chcbaram/convex/firmware/convex-boot/docs/web_update_plan.md

# 웹페이지 → 앱 경유 펌웨어 업데이트 / SLOT 저장 검토

질문: "앱에서 웹페이지를 통해 펌웨어 업데이트와 SLOT 데이터 저장을 지원하고 싶다.
부트로더가 아니라 앱에만 추가하면 될 것 같은데 맞나?"

**결론: 맞다. 부트로더 수정 없이 앱(`convex-qmk`) + 웹페이지만으로 구현 가능하다.**
그리고 이 방식은 이미 출하된 보드에도 그대로 적용된다 — 부트로더의 MSC/UF2 문제를
전부 우회하기 때문에, 출하품 대응의 실질적인 해법이다.

구현은 부트로더 수정과 같은 `fix/uf2-msc-robustness` 브랜치에서 이어서 진행한다.

---

## 1. 왜 부트로더 수정이 필요 없는가

부트로더가 이미 "QSPI 업데이트 영역을 읽어 내부 플래시에 적용"하는 경로를 갖고 있고,
그 트리거가 RTC 백업 레지스터에 있기 때문이다.

`convex-boot/src/ap/ap.c` `bootUp()`:

```c
if (boot_param & (1<<MODE_BIT_UPDATE))
{
  boot_param &= ~(1<<MODE_BIT_UPDATE);
  resetSetBootMode(boot_param);
  is_run_fw    = true;
  is_update_fw = true;
}
...
if (is_update_fw)
{
  err_code = bootUpdateFirm();     // CRC 검증 -> 내부 플래시 erase/write -> 재검증
}
```

즉 앱이 할 일은 **QSPI 업데이트 영역 채우기 + 태그 쓰기 + `MODE_BIT_UPDATE` 세팅 후 리셋**이 전부다.
MSC·UF2·FAT·파일 복사는 전혀 개입하지 않는다.

앱 쪽 부품도 이미 다 있다:

| 필요한 것 | 이미 있는 것 | 위치 |
|---|---|---|
| QSPI 업데이트 영역 기록 + 태그 생성 | `loaderDownToFlash()` (UART/YMODEM 판) | `convex-qmk/src/hw/driver/loader.c` |
| 업데이트 모드로 리셋 | `resetSetBootMode(1<<MODE_BIT_UPDATE)` + `resetToReset()` | `convex-qmk/src/hw/driver/reset.c:163` |
| 슬롯 영역 읽기/재생 | `gif_app.c` + LVGL FS 드라이버 | `convex-qmk/.../app/gif/gif_app.c` |
| 플래시 추상화 | `flashErase/flashWrite/flashRead` (QSPI 자동 라우팅) | `convex-qmk/src/hw/driver/flash.c` |

바꿔야 할 것은 **전송 계층뿐**이다. YMODEM/UART → 웹 브라우저.

---

## 2. 동작 흐름

### 2-1. 펌웨어 업데이트

```
웹페이지                    앱(convex-qmk)                     부트로더
   |                            |                                |
   |-- BEGIN(FIRM, size) ------>| QSPI 업데이트 영역 erase        |
   |<-- ACK ---------------------|                                |
   |-- DATA(offset, payload) -->| flashWrite(0x90000400+offset)   |
   |        ... 반복 ...         |                                |
   |-- END(crc) --------------->| flash 재독 -> CRC 검증          |
   |                            | firm_tag_t 를 0x90000000 에 기록 |
   |<-- RESULT(ok/err) ----------|                                |
   |-- COMMIT ----------------->| resetSetBootMode(MODE_BIT_UPDATE)|
   |                            | resetToReset() ---------------->| bootUpdateFirm()
   |                            |                                 | CRC 검증
   |                            |                                 | 내부 플래시 복사
   |                            |                                 | bootJumpFirm()
```

**안전성**: 앱은 QSPI(외부 플래시)에만 쓴다. 실행 중인 펌웨어는 내부 플래시에 그대로 있으므로
전송이 중간에 끊겨도 벽돌이 되지 않는다. 부트로더도 `bootUpdateFirm()` 에서 CRC 를 먼저 검증하고,
실패하면 기존 펌웨어로 그냥 부팅한다.

### 2-2. SLOT 데이터 저장

부트로더가 아예 개입하지 않으므로 더 간단하다.

```
웹 -- BEGIN(SLOT n, size) --> 앱: 슬롯 전체(2MB) erase
    -- DATA(offset, ...) ---> 앱: flashWrite(slot_base + 0x400 + offset)
    -- END(crc) ------------> 앱: flash 재독 CRC 검증 -> 결과 회신
```

리셋도 필요 없다. `gif_app` 의 `slot_run` 을 `SLOT_MAX_CH` 로 되돌리면 다음 진입 때 다시 읽는다.

헤더 규약은 지금 `index.html` 이 만드는 것과 동일하게 유지한다
(0..15 매직 문자열, 16..19 파일 크기 LE, 32부터 원본). 기존 UF2 경로와 호환된다.

---

## 3. 전송 계층 선택 (Windows / macOS / Linux 모두 지원해야 함)

이 보드는 이미 **raw HID(VIA)** 와 **CDC** 인터페이스를 모두 노출한다
(`convex-qmk/src/hw/driver/usb/usb_cmp/usbd_cmp.c`, `hw_def.h` 의 `_USE_HW_CDC`).
새 USB 인터페이스를 추가하지 않아도 된다.

| 방식 | OS 지원 | 브라우저 | 드라이버/권한 | 속도 |
|---|---|---|---|---|
| **WebHID** (raw HID, usage page 0xFF60) | Win / macOS / Linux 모두 | Chrome·Edge (Safari·Firefox ✗) | Win·macOS 무설정. **Linux 는 udev 규칙 필요** | report 64B 기준 full-speed 1ms → 실효 수십 KB/s |
| **WebSerial** (CDC) | Win / macOS / Linux 모두 | Chrome·Edge (Safari·Firefox ✗) | Win10+ 자동(usbser). macOS 무설정. **Linux 는 dialout 그룹 또는 udev** | bulk 64B×여러 패킷 → 수백 KB/s |
| WebUSB (vendor 인터페이스 신설) | Win 은 WinUSB 바인딩 필요(WCID 디스크립터) | Chrome·Edge | Linux udev 필요 | 가장 빠름 |

### 권장

**WebHID 를 기본, WebSerial 을 대용량용으로** 두는 조합을 권한다.

- WebHID 는 VIA 가 정확히 같은 인터페이스로 세 OS에서 동작하는 것이 검증돼 있고,
  Linux udev 규칙도 키보드 커뮤니티에서 이미 표준화된 형태가 있다.
- 다만 raw HID 는 report 크기가 작아 1.7MB 펌웨어 전송에 수십 초가 걸린다.
  펌웨어와 대용량 GIF 는 CDC(WebSerial)가 현실적이다.
- WebUSB 는 Windows 에서 WinUSB 바인딩을 위해 WCID(MS OS 2.0) 디스크립터를 추가해야 해서
  "세 OS 무설정" 목표에 오히려 불리하다. 권하지 않는다.

### 반드시 챙길 것

1. **HTTPS 필수** — WebHID/WebSerial 은 secure context 에서만 동작한다.
   지금처럼 GitHub Pages 로 서비스하면 충족된다. `file://` 로 열면 동작하지 않는다.
2. **Safari / Firefox 미지원** — 웹페이지에서 `navigator.hid`/`navigator.serial` 존재 여부를
   먼저 검사하고, 없으면 "Chrome 또는 Edge 를 사용하세요 + 기존 UF2 다운로드" 대체 경로를 안내한다.
   기존 UF2 생성기를 지우지 말고 fallback 으로 남겨둘 것.
3. **Linux 권한 안내** — udev 규칙(`/etc/udev/rules.d/`) 예시를 페이지에 함께 제공한다.
   이게 없으면 Linux 에서 장치가 목록에 뜨지 않는다. 세 OS 지원에서 가장 흔한 실패 지점이다.
4. **사용자 제스처 필요** — `requestDevice()` 는 클릭 등 사용자 조작 안에서만 호출 가능하다.

---

## 4. 프로토콜 설계 권고

부트로더 UF2 경로에서 문제가 됐던 것들을 처음부터 배제하는 형태로 만든다.

| 규칙 | 이유 |
|---|---|
| 모든 DATA 패킷에 **절대 오프셋**을 넣는다 | 순서/중복에 무관해진다. UF2 경로의 B-1~B-3 이 전부 이 문제였다 |
| erase 는 **BEGIN 에서 대상 영역 전체를 한 번에** | 블록 단위 on-demand erase 는 순서가 뒤바뀌면 기록한 데이터를 지운다 |
| END 에서 **기기가 flash 를 다시 읽어 CRC 검증** 후 결과 회신 | MSC 로는 불가능했던 "성공/실패를 사용자에게 알리기"가 된다 |
| 모든 명령에 응답(ACK/NAK + 상태 코드) | 실패를 성공으로 보고하던 A-4 문제가 구조적으로 사라진다 |
| 진행률을 LCD 에 표시 | 기존 `lcd_req_info_t` / `LCD_INFO_MODE_PROGRESS` 재사용 |

명령 예시:

```
BEGIN  : target(FIRM|SLOT), slot_no, total_size          -> ACK / ERR_SIZE, ERR_BUSY
DATA   : offset(u32), len(u16), payload                  -> ACK / ERR_WRITE
END    : crc16(u16)                                      -> ACK / ERR_CRC
COMMIT : (FIRM 일 때만) 업데이트 모드로 리셋              -> (응답 후 리셋)
STATUS : 진행 상태 조회                                   -> state, percent, err_code
```

---

## 5. 앱 구현 시 주의할 점

1. **QSPI XIP 모드** — `qspiRead/Write/Erase` 에 `assert(qspiGetXipMode() == false)` 가 있다.
   GIF 재생 경로와 기록 경로가 QSPI 를 동시에 건드리지 않도록 락 또는 상태 배타 처리가 필요하다.
2. **erase 블로킹** — 64KB erase 가 150ms 이상 걸린다. 슬롯 2MB 전체면 32회 = 약 5초.
   `_USE_HW_RTOS` 가 켜져 있으므로 별도 스레드에서 진행하고, 키 스캔/USB/LCD 는 계속 돌게 한다.
   한 번에 다 지우지 말고 청크로 나눠 진행률을 갱신하는 편이 사용자 경험상 낫다.
3. **런타임 동적 할당 금지** — 고정 크기 수신 버퍼를 쓴다.
4. **기존 UF2 경로와 공존** — 부트로더 MSC 경로는 그대로 남는다.
   웹 방식이 안정화되면 사용자 안내에서 UF2 드래그 방식을 보조 수단으로 내리는 것을 권한다.

---

## 6. 부트로더 자체를 앱에서 갱신할 수 있는가

**가능하다.** 흔히 쓰는 방식이기도 하다 (Adafruit 은 `update-bootloader-*.uf2` 라는
"부트로더를 갱신하는 앱 펌웨어"를 배포한다). 다만 조건이 있다.

### 6-1. 이 보드의 조건 (스키매틱 5페이지 `R_MCU` 확인)

| 항목 | 확인 결과 |
|---|---|
| MCU | STM32H743VIT6 (2MB, dual bank, **섹터 128KB**, 뱅크당 8섹터) |
| 부트로더 영역 | `0x08000000`~`0x0803FFFF` = **bank1 섹터 0~1** 에 정확히 정렬됨 |
| 펌웨어 영역 | `0x08040000`~ = bank1 섹터 2~7 + bank2 전체 |
| **BOOT0 버튼** | **있음.** `SW2`(TS-1187A) 가 BOOT0 를 `R_+3V3` 에 연결, `R5` 10k 풀다운 |
| **RESET 버튼** | **있음.** `SW1`(TS-1187) 이 NRST 에 연결 |
| SWD / UART 헤더 | **있음.** `H1`(PH-01291) 에 SWDIO / SWCLK / USART1_TX / USART1_RX |
| USB | Type-C, D+/D− 가 PA11/PA12 (ST ROM 부트로더의 DFU 핀과 동일) |

**즉 최악의 경우 복구 경로가 존재한다.** BOOT0 를 누른 채 RESET → STM32 ROM 부트로더
(system memory) 진입 → USB DFU 로 STM32CubeProgrammer / dfu-util 재기록.
SWD 나 UART 부트로더로도 가능하다.
이것이 "부트로더 갱신을 시도해도 되는가"를 가르는 핵심 근거다.

> **기구 확인 필요**: 조립된 상태에서 사용자가 BOOT0/RESET 버튼에 접근할 수 있는가?
> 접근 가능하면 실패해도 사용자 자력 복구가 되고, 불가능하면 분해/RMA 가 된다.
> 이 한 가지가 리스크 수용 여부를 결정한다.

### 6-2. 반드시 지켜야 할 구현 조건

1. **erase/program 루틴을 RAM 에서 실행해야 한다.** ← 가장 중요
   갱신 코드는 bank1 섹터 2 이후에 있고 지우려는 대상은 bank1 섹터 0~1 이다.
   STM32H7 은 erase/program 중인 뱅크로의 읽기가 stall 되므로, **같은 뱅크에서 실행하면 안 된다.**
   루틴(그리고 그 루틴이 호출하는 HAL 코드·상수)을 ITCM/DTCM 으로 복사해 실행하고
   인터럽트를 끄거나 벡터 테이블을 RAM 으로 옮긴다.
   - 현재 `flashWrite()` 는 대상 주소를 `memcpy` 로 되읽는 코드가 있어 그대로는 못 쓴다.
     부트로더 갱신 전용으로 32바이트 정렬·전체 이미지 기록만 하는 별도 루틴을 둔다.
   - bank2(`0x08100000`+)에 링크해 cross-bank read-while-write 로 푸는 방법도 있으나,
     호출되는 모든 코드/상수 배치를 보장해야 해서 취약하다. RAM 방식이 확실하다.
2. **H7 은 32바이트(256bit) 플래시 워드 단위로 기록하고, erase 없이 같은 워드를 두 번 쓸 수 없다.**
   이미지 전체를 32바이트 정렬로 한 번에 기록한다.
3. **새 부트로더 이미지를 QSPI 에 먼저 저장하고 CRC 검증에 통과한 뒤에만** 내부 플래시를 건드린다.
   전송 실패로 인한 브릭을 원천 차단한다.
4. **취약 구간을 짧게.** 256KB = 128KB 섹터 2개 erase + 프로그램 → 대략 1~3초.
   그동안 "케이블을 뽑지 마세요"를 LCD 에 표시한다. USB 버스 파워라 사용자가 뽑으면 끝이다.
5. 갱신 후 **재검증(CRC)** 하고, 실패하면 즉시 재시도하도록 유도한다.

### 6-3. 검토했으나 이 보드에는 쓸 수 없는 안전장치

`BOOT_ADD0` 옵션 바이트로 부트 주소를 임시로 펌웨어 쪽으로 돌려두면, 부트로더가 지워진 상태에서
전원이 끊겨도 다음 부팅에 펌웨어가 떠서 재시도할 수 있다. 이론상 가장 강한 보호책이다.

**그러나 지금 구조에는 적용할 수 없다.** `BOOT_ADD` 는 64KB 단위로만 지정되는데,
펌웨어의 실제 벡터 테이블은 태그(`FLASH_SIZE_TAG` = 0x400) 때문에 `0x08040400` 에 있다.
`0x08040000` 을 지정하면 태그를 벡터 테이블로 오인한다.

→ 쓰려면 태그를 벡터 뒤로 옮기거나 `0x08040000` 에 64KB 정렬 복구 스텁을 두는 **구조 변경**이
필요하고, 이는 출하품에 소급 적용할 수 없다. 차기 리비전 설계 시 고려할 항목이다.

### 6-4. 권고

in-place 방식은 아래 7절의 A/B 방식보다 모든 면에서 열등하다. **7절을 채택한다.**

---

## 7. A/B 방식 — 실제 플래시 사용 현황과 두 가지 안

### 7-1. 현재 내부 플래시 사용 현황 (실측)

STM32H743VI = 2MB, dual bank, 뱅크당 1MB / 128KB 섹터 8개.

| 영역 | 주소 | 크기 | 뱅크 |
|---|---|---|---|
| 부트로더 | `0x08000000`~`0x0803FFFF` | 256KB (실제 text 133KB) | bank1 섹터 0~1 |
| 펌웨어 | `0x08040000`~`0x080E55A8` | **661KB** (태그 포함, 실측) | bank1 섹터 2~7 |
| **미사용** | `0x080E55A8`~`0x080FFFFF` | 약 107KB | bank1 |
| **미사용** | `0x08100000`~`0x081FFFFF` | **1MB 전체** | **bank2** |

실측 방법: `convex-qmk` 빌드 → `convex-qmk.bin` = 676,264 B, `+ FLASH_SIZE_TAG(0x400)` = 677,288 B.
끝 주소 `0x080E55A8` 은 뱅크 경계 `0x08100000` 아래다.

EEPROM 은 외부 I2C(`BL24C256`, 스키매틱 U119)를 쓰므로 내부 플래시를 점유하지 않는다.
즉 **bank2 1MB 는 완전히 비어 있다.**

> 참고: `hw_def.h` 의 `FLASH_SIZE_FIRM` 은 1.75MB, `STM32H743XX_FLASH_BOOT.ld` 의 FLASH LENGTH 는
> `1024K - 3K` 로 선언되어 있어 **정의상으로는** 펌웨어가 bank2 로 넘어갈 수 있다.
> 아래 두 안 모두 펌웨어를 bank1 안에 묶어야 하므로 이 값들을 조여야 한다.

### 7-2. 안 A — `BOOT_ADD0` 로 부트로더만 A/B

새 부트로더를 `0x08100000`(bank2 섹터 0~1, 64KB 정렬 ✔)에 기록하고 검증한 뒤
`BOOT_ADD0` 를 `0x0810` 으로 바꾸고 OB launch → 리셋.

- 기존 부트로더는 `0x08000000` 에 그대로 남아 있으므로 **부트로더가 없는 순간이 존재하지 않는다.**
- 실패해도 `BOOT_ADD0` 를 안 바꾸면 그만이다. 롤백도 값만 되돌리면 된다.
- 펌웨어 영역을 줄일 필요가 없다 (bank2 가 비어 있으므로).
- **단점**: 슬롯 B 는 `0x08100000` 에서 실행되므로 **그 주소로 따로 링크한 빌드**가 필요하다.
  A 슬롯용/B 슬롯용 두 벌을 유지해야 하고, 매번 "지금 어느 슬롯인지" 보고 반대편에 써야 한다.

### 7-3. 안 B — `SWAP_BANK` 로 부트로더+펌웨어 통째로 A/B  ← **권장**

STM32H7 은 `SWAP_BANK` 옵션 비트로 **bank1 과 bank2 의 주소 맵을 통째로 맞바꾼다.**
정확히 이 용도로 있는 기능이다.

현재 이미지 총합 = 부트로더 256KB + 펌웨어 661KB = **917KB → 1MB 뱅크 하나에 들어간다.**

```
        [현재]                              [SWAP_BANK 플립 후]
0x08000000  물리 bank1 (구 부트로더+펌웨어)   0x08000000  물리 bank2 (신 부트로더+펌웨어)
0x08100000  물리 bank2 (신 이미지 기록 대상)  0x08100000  물리 bank1 (구 이미지 = 롤백용)
```

절차:
1. 앱이 **부트로더+펌웨어를 합친 새 이미지**를 `0x08100000` 에 기록 (현재 실행 중인 bank1 과 다른 뱅크)
2. flash 재독 CRC 검증
3. `SWAP_BANK` 옵션 비트 플립 → OB launch → 리셋
4. 새 이미지가 `0x08000000` 에 나타나 부팅

**결정적 장점: 재링크가 필요 없다.** 기록할 때는 `0x08100000` 에 쓰지만 플립 후에는 그 뱅크가
`0x08000000` 이 되므로, 이미지는 **지금과 똑같이 `0x08000000` 기준으로 링크된 것**을 그대로 쓴다.
안 A 의 가장 큰 부담(슬롯별 링크 주소 관리)이 사라진다.

부가 장점:
- **부트로더와 펌웨어를 한 번에, 원자적으로** 교체한다.
- 롤백 = 옵션 비트를 되돌리면 끝. 구 이미지가 반대 뱅크에 온전히 남아 있다.
- 실행 중인 코드(bank1)와 기록 대상(bank2)이 다른 뱅크라 **cross-bank read-while-write** 가 되므로,
  in-place 방식에서 필수였던 RAM 상주 루틴이 없어도 된다.

제약:
- **이미지 총합이 1MB 를 넘으면 안 된다.** 현재 917KB, 여유 107KB.
  펌웨어 상한을 768KB(= 1MB − 부트로더 256KB)로 잡고 `_BOOT.ld` 의 FLASH LENGTH 를
  `1024K - 3K` → `768K - 3K` 로 조여 링커가 강제하게 한다.
  LVGL·GIF 디코더가 들어 있어 증가 여지가 있으므로 **크기 감시가 필요하다.**
- 구현 전 **RM0433 에서 확인할 것**:
  `SWAP_BANK` 설정 시 FLASH 제어 레지스터의 뱅크 번호도 함께 스왑되는지 (erase 대상 지정에 직결).
  그리고 STM32H743 errata sheet 의 `SWAP_BANK` 관련 항목.
- 옵션 바이트 기록은 OB launch 로 리셋을 동반한다.

### 7-4. 세 방식 비교

| | in-place (6절) | 안 A `BOOT_ADD0` | 안 B `SWAP_BANK` |
|---|---|---|---|
| 부트로더 없는 취약 구간 | **1~3초 존재** | 없음 | 없음 |
| 커밋 동작 | 없음(순차 기록) | 옵션바이트 1회 | 옵션바이트 1회 |
| 슬롯별 재링크 | 불필요 | **필요** | **불필요** |
| RAM 상주 루틴 | **필수** | 권장 | 불필요 |
| 부트로더+펌웨어 동시 갱신 | 불가 | 불가 | **가능** |
| 롤백 | 불가 | 가능 | 가능 |
| 필요 공간 | 0 | bank2 256KB | bank2 1MB |
| 주 제약 | 브릭 위험 | 슬롯 링크 관리 | 이미지 ≤1MB (현 917KB) |

### 7-5. 권고

1. **안 B(`SWAP_BANK`) 를 채택한다.** 현재 이미지가 917KB 로 한 뱅크에 들어가고,
   재링크가 필요 없다는 점이 결정적이다.
2. 다만 **순서는 4~5절의 앱 경유 웹 업데이트가 먼저다.** 그것만으로 부트로더의 MSC/UF2 문제가
   출하품에서도 우회되므로, 부트로더를 갱신할 이유 자체가 크게 줄어든다.
   부트로더 A/B 는 그 다음 단계로 둔다.
3. 착수 전 확인:
   - RM0433 의 `SWAP_BANK` 레지스터 semantics + H743 errata
   - **BOOT0/RESET 버튼의 조립 후 접근성** (최후 복구 수단이 유지되는지)
   - `BOOT_ADD1` 은 기본값 `0x1FF0`(system memory) 그대로 둘 것.
     여기를 다른 용도로 돌리면 **BOOT0 → ROM DFU 복구 경로를 잃는다.**
4. 새 이미지가 부팅 후 일정 시간 안에 "확인" 플래그를 남기지 않으면 다음 부팅에서 자동으로
   되돌리는 confirm/rollback 절차를 새 부트로더에 넣으면 더 안전하다.

---

## 8. 전송 데이터 압축 검토 (실측)

### 8-1. 압축률 실측

`convex-qmk.bin` (676,264 B) 기준:

| 방식 | 결과 | 비율 |
|---|---|---|
| 원본 | 676,264 B | 100% |
| deflate-raw 전체 스트림 | 376,317 B | **55.6%** |
| 블록 deflate 4KB 단위 | 402,353 B | 59.5% |
| 블록 deflate 8KB 단위 | 394,007 B | 58.3% |
| 블록 deflate 16KB 단위 | 389,764 B | 57.6% |
| lzma/xz | 327,264 B | 48.4% |

**"일정 크기 단위로 나눠 압축해도 되는가" → 된다.**
4KB 블록 단위로 잘라도 전체 스트림 대비 손해가 **3.9%p** 뿐이다.
블록마다 독립적으로 압축/해제되므로 오프셋 기반 순서·중복 무관 설계도 그대로 유지된다.

### 8-2. 그러나 SLOT(GIF) 은 압축 이득이 없다

**GIF 는 이미 LZW 로 압축된 포맷이다.** 이미 압축된 데이터를 다시 압축하면 이득이 없다는 것을
확인했다 (재압축 결과 100.0%, 즉 제자리).

즉 압축은 **펌웨어에만** 의미가 있고, 정작 자주 하는 작업인 **GIF 슬롯 저장에는 무의미하다.**

### 8-3. 압축보다 리포트 크기를 키우는 쪽이 효과가 크다

VIA raw HID 는 32B 리포트 / `bInterval=1`(full-speed 1ms) 이므로 **32 KB/s 가 물리적 상한**이다.
full-speed interrupt 엔드포인트는 최대 64B 까지 가능하므로, VIA 와 별개의 전용 HID 인터페이스를
64B 리포트로 추가하면 상한이 두 배가 된다. 이건 **GIF 에도 그대로 효과가 있다.**

| 구성 | 펌웨어 676KB | GIF 2MB |
|---|---|---|
| 32B 리포트(VIA 재사용), 무압축 — payload 26B | 26 s | 81 s |
| 32B + 블록 deflate | 16 s | 81 s (이득 없음) |
| **64B 전용 리포트, 무압축 — payload 58B** | **12 s** | **36 s** |
| 64B + 블록 deflate | 7 s | 36 s |

### 8-4. 권고

1. **1단계: 압축 없이 VIA 32B 리포트로 먼저 구현한다.** 동작하는 것을 먼저 확보한다.
   펌웨어 26초, GIF 500KB 20초 — 수용 가능한 수준이다.
2. **압축을 넣는다면 펌웨어에만, 4KB 블록 deflate 로.** GIF/SLOT 에는 넣지 않는다.
   - 호스트측은 Chrome 내장 `CompressionStream('deflate-raw')` 로 의존성 없이 가능하다.
   - 장치측은 tinfl(miniz) 계열 해제기 약 5~10KB 가 필요하다.
     7절 SWAP_BANK A/B 의 여유 107KB 를 잠식하므로 크기 감시가 필요하다.
   - 앱이 해제해서 **원본을 QSPI 에 기록**하므로 태그 CRC 는 원본 기준 그대로다.
     → **부트로더는 전혀 손대지 않아도 된다.**
3. **속도가 더 필요하면 압축보다 64B 전용 HID 인터페이스를 먼저 검토한다.**
   효과가 2.2배로 더 크고, 압축과 달리 GIF 에도 적용된다.
   다만 컴포지트 디스크립터(`usbd_cmp.c`)를 건드려야 하므로 VIA/키보드 열거에 영향이 없는지
   확인이 필요하다.

---

## 9. 웹페이지에서 USB 드라이브에 직접 복사 (File System Access API)

부트로더 MSC 모드로 들어갔을 때, 사용자가 `.uf2` 를 내려받아 손으로 끌어다 놓는 대신
**웹페이지에서 드라이브를 선택하면 바로 써주는 것**이 가능하다.

`window.showDirectoryPicker({ mode: 'readwrite' })` 로 드라이브를 고르게 하고,
`getFileHandle(name, {create:true})` → `createWritable()` → `write()` 로 기록한다.

- 브라우저 지원은 **Chrome·Edge** 로 WebHID 와 동일하다. 즉 제약이 늘지 않는다.
- Windows / macOS / Linux 모두에서 이동식 드라이브 선택이 가능하다.
- **보안상 사용자가 매번 드라이브를 직접 선택해야 한다.** 브라우저가 임의 경로에 조용히 쓰는 것은
  구조적으로 불가능하므로 이 단계는 없앨 수 없다. 다만 핸들을 IndexedDB 에 저장해두고
  `queryPermission()`/`requestPermission()` 으로 재사용하면 다음부터는 클릭 한 번이다.
- **잘못된 드라이브 방지**: 쓰기 전에 `README.TXT` 를 읽어 `BARAM BOOT` 인지, 보드 이름/버전이
  맞는지 확인하고 사용자에게 보여준다. 아니면 거부한다.
- **주의**: 마지막 블록을 받으면 기기가 리셋되어 드라이브가 사라지므로 `close()` 가 예외를 던진다.
  이건 정상 동작이므로 성공으로 처리해야 한다.
  (`createWritable()` 이 임시 파일을 거쳐도 부트로더는 파일명을 보지 않고 섹터 내용의 UF2 매직만
  보므로 문제되지 않는다.)
- **한계**: 이 경로는 결국 OS 파일시스템을 통과하므로 `uf2_msc_review.md` 의 MSC/UF2 문제를
  그대로 안고 간다. **편의 개선이지 견고성 개선이 아니다.**

### 제공 경로 우선순위

| 순위 | 조건 | 방식 |
|---|---|---|
| 1 | Chrome·Edge + 앱 실행 중 | **WebHID 직접 전송** (가장 안전·간편) |
| 2 | Chrome·Edge + 부트로더 MSC 모드 | 드라이브 선택 후 자동 복사 |
| 3 | 그 외 브라우저 | `.uf2` 다운로드 후 수동 복사 (기존 방식 유지) |

---

## 10. 슬롯 목록 UI (검토)

요구: 슬롯 목록에서 현재 상태를 보고, 파일 하나를 지정한 뒤
라디오 버튼으로 넣을 슬롯 하나를 골라 업데이트하거나 UF2 로 내려받는다.

### 10-1. 결론

**가능하고, 지금 넣는 것이 좋다.** 장치에 명령 하나(`CMD_SLOT_INFO`)만 추가하면 된다.

처음에는 "슬롯마다 파일을 지정해 한꺼번에 업데이트"를 검토했으나,
**파일 하나 + 라디오로 슬롯 하나 선택**이 더 낫다는 결론이다.

핵심 가치는 "어느 슬롯에 무엇이 들어 있는지 보면서 고르는 것"인데
그것은 라디오 목록만으로 충분히 달성된다. 슬롯별 파일 지정은 거기에
배치 처리 복잡도만 더한다.

| | 슬롯별 파일 지정 | **파일 1개 + 라디오** |
|---|---|---|
| 웹 코드 | 약 150줄 | 약 70줄 |
| UF2 다운로드 | 파일 여러 개 → ZIP 필요 | **파일 1개, 지금 방식 그대로** |
| 합친 UF2 제약 | 부딪힘 (아래 10-4) | **해당 없음** |
| 전송 시간 | 4슬롯 최대 약 80초, 중단 버튼 필요 | 약 20초, 단순 |
| 실패 처리 | 슬롯별 부분 실패 상태 관리 | 한 번에 하나라 단순 |
| 실제 사용 패턴 | 드묾 (초기 설정 1회) | 흔함 (GIF 교체) |

### 10-2. 슬롯 상태 읽기 — 명령 추가 필요

지금 프로토콜에서 장치 값을 읽는 수단은 `INFO` 뿐이고 VIA 에도 QSPI 를
읽는 명령이 없다. 따라서 `CMD_SLOT_INFO` 가 필요하다.

읽을 정보는 이미 슬롯에 다 있다 (`gif_app.c` 가 쓰는 배치와 동일):

| 오프셋 | 내용 |
|---|---|
| `+0` | 매직 문자열 16B (`GIF_IMAGE` / `GIF_MOVIE`) |
| `+16` | 파일 크기 u32 |
| `+32` | 원본 GIF 시작 → `+32+6` 에 논리 화면 크기 (w, h) |

슬롯당 **사용 여부 · 크기 · 종류 · 해상도**를 전부 회신할 수 있다.
32바이트 리포트 하나에 슬롯 하나씩 담아 4회 왕복이면 끝난다.
슬롯 개수는 `INFO` 가 이미 알려주므로 목록을 하드코딩하지 않아도 된다.

QSPI 읽기는 이미 뮤텍스로 보호되어 GIF 재생과 충돌하지 않는다.

**타이밍**: 프로토콜 v1 은 아직 배포되지 않았다. 지금 넣으면 v1 에 흡수되지만
나중에 넣으면 "구형 펌웨어에서는 슬롯 상태가 안 보임" 분기를 영구히 안게 된다.

### 10-3. 화면 구성

```
파일: [ my.gif ]  412 KB · 284 x 76

  ( ) SLOT 1   GIF_IMAGE   284 x 76   412 KB
  (o) SLOT 2   GIF_MOVIE   284 x 76   980 KB     <- 덮어씀
  ( ) SLOT 3   비어 있음
  ( ) SLOT 4   비어 있음                      [ 새로고침 ]

  [ 기기에 바로 전송 ]  [ 드라이브에 바로 쓰기 ]  [ UF2 다운로드 ]
```

- 선택한 슬롯에 내용이 있으면 "덮어씀"을 표시해 실수를 막는다.
- 전송 성공 후 해당 행만 다시 읽어 갱신한다.
- 파일을 고르면 **미리보기**를 보여준다. `URL.createObjectURL(file)` 을 `<img>` 에
  넣으면 애니메이션 GIF 도 그대로 재생된다. 미리보기 틀을 LCD 와 같은
  284 x 76, 배경 검정, `overflow:hidden`, 이미지 가운데 정렬로 만들면
  기기에서 보이는 모습과 거의 같다
  (`gif_app.c` 도 검정 배경에 `lv_obj_center()` 로 가운데 정렬한다).
  다만 브라우저와 LVGL 의 GIF 디코더가 달라 **재생 가능 여부까지 보장하지는 않는다.**
- **연결 전이거나 구형 펌웨어면** 상태 없이 `SLOT 1~4` 행만 표시한다.
  UF2 다운로드/드라이브 쓰기 경로는 그대로 동작해야 하므로 목록 자체는 항상 보인다.

### 10-4. 참고 — 합친 UF2 가 안 되는 이유

이 설계에서는 해당 없지만 기록해 둔다.
부트로더는 첫 familyID 의 블록이 다 차면 `is_done_req` 를 세우고
`UF2_COMPLETE_WAIT_MS(1000) + UF2_JUMP_WAIT_MS(300)` 뒤 펌웨어로 점프한다.
뒤에 붙인 다른 슬롯 블록은 그 사이에 잘린다.
출하품의 구형 부트로더는 애초에 한 세션에 두 파일을 못 받는다 (B-6).
→ 슬롯을 하나의 UF2 로 합치면 안 된다.

### 10-5. 비용과 되돌리기

| 항목 | 규모 |
|---|---|
| 장치 `CMD_SLOT_INFO` | 약 50줄, 크기 영향 무시 수준 |
| 웹 슬롯 목록 UI | 약 70줄 |
| 위험 | 낮음. 기존 단일 슬롯 경로를 확장하는 형태 |

되돌리기 쉽도록 `try/slot-list` 브랜치에서 **단일 커밋**으로 진행한다.
마음에 들지 않으면 브랜치를 지우고, 좋으면 합친다.

선택 항목: 행마다 "비우기" 버튼을 두려면 `CMD_SLOT_ERASE` 가 추가로 필요하다.
지금은 넣지 않는다.

---

## 11. 그 외 남는 것

- 부트로더 모드로 진입해 UF2 를 드래그하는 기존 경로의 버그는 출하품에 그대로 남는다.
  → `uf2_msc_review.md` 의 C 절 참고. 웹 방식을 기본 경로로 안내해 회피한다.
