chcbaram/convex/hardware/SCH_SCH-CONVEX_2025-11-16.pdf

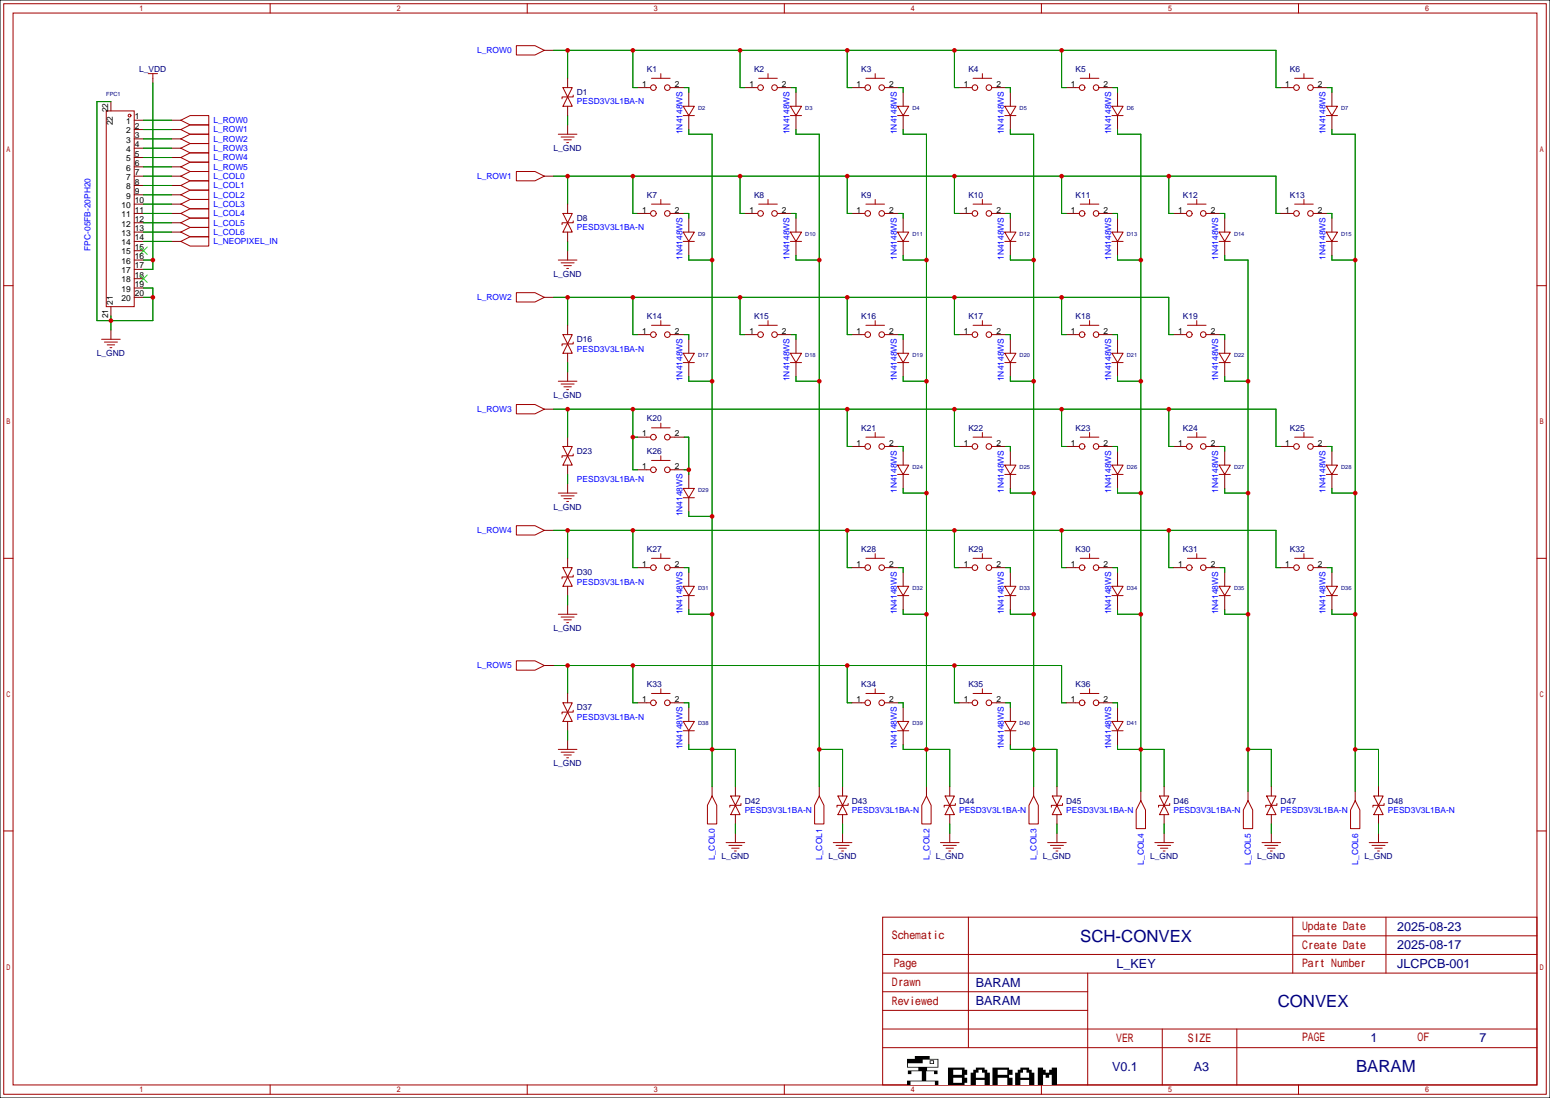
[picture p1: page 1]

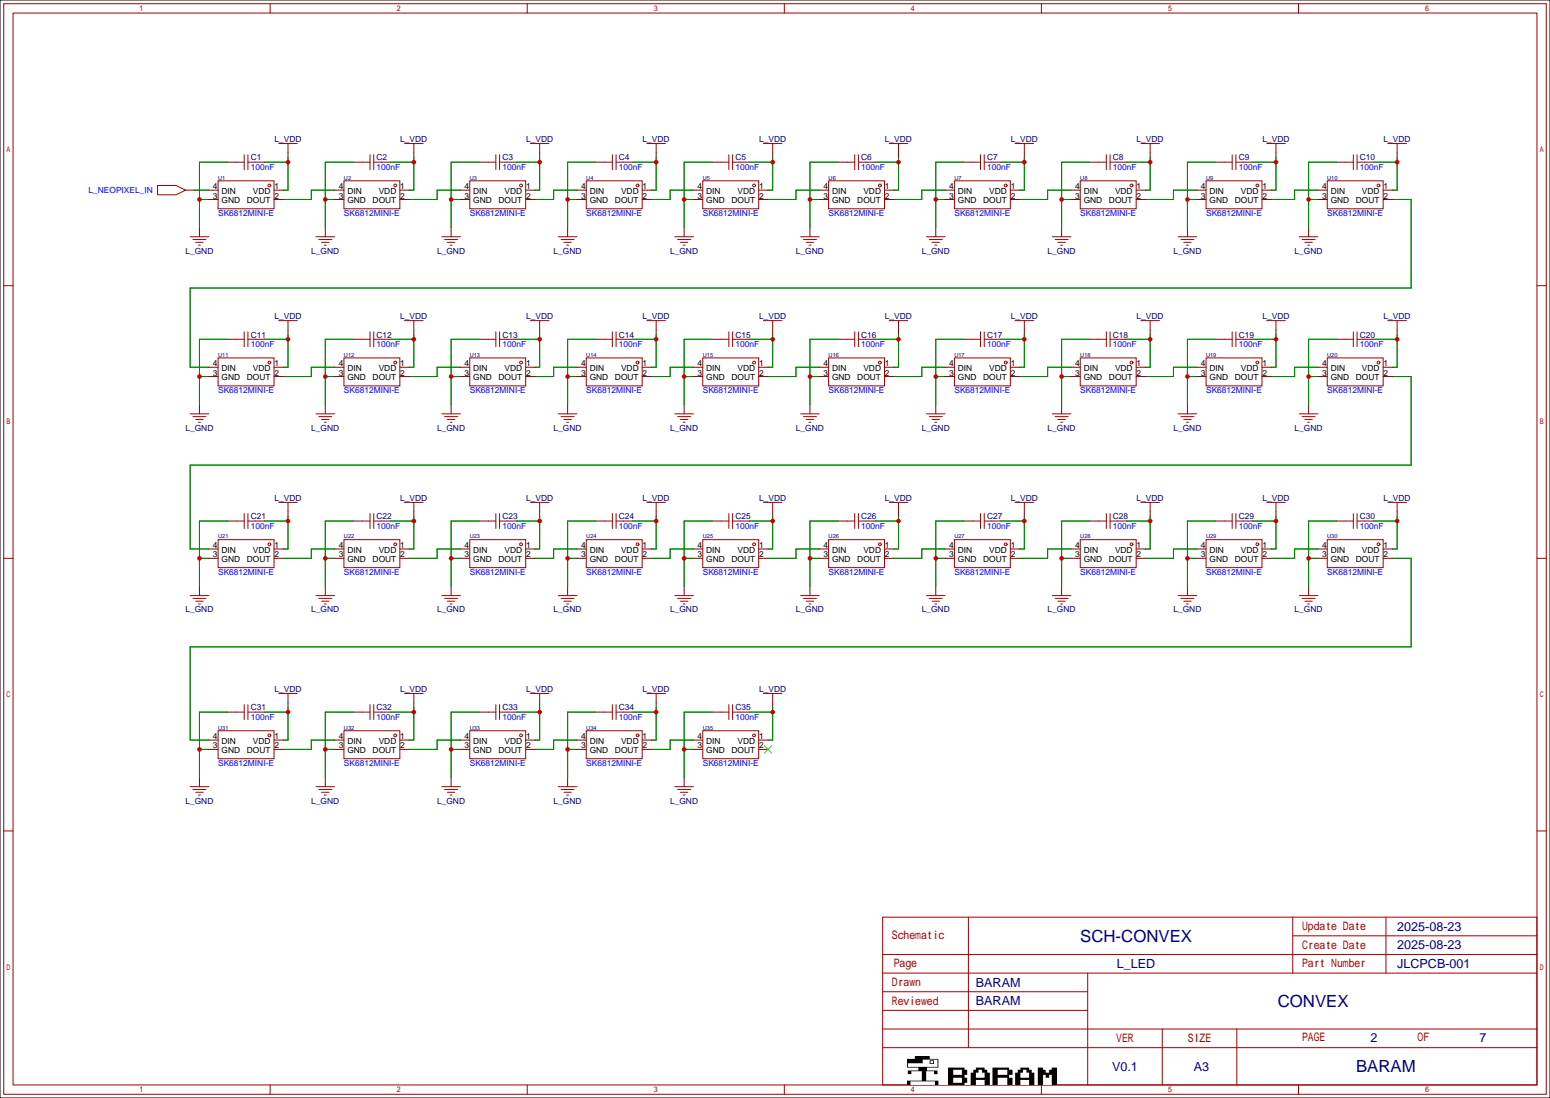
[picture p2: page 2]

10 10 11 11 12 12 13 13 14 14 15 15 16 16 17 17 18 18 19 19 20 20

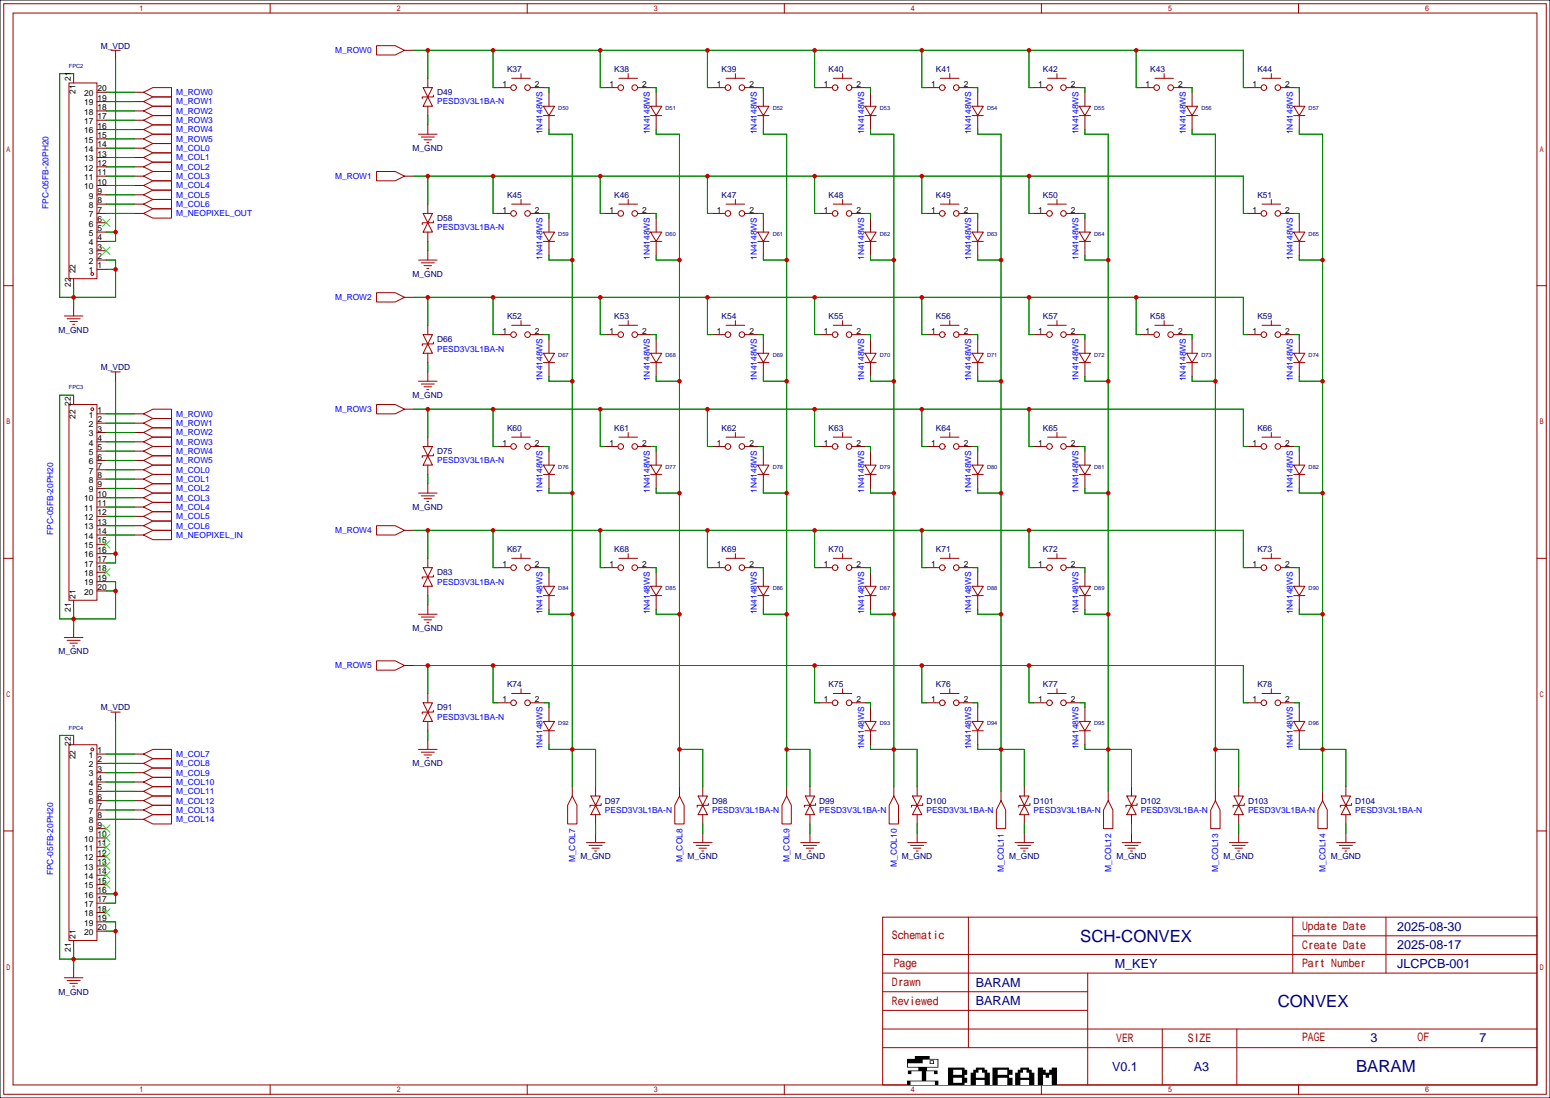
[picture p3: page 3]

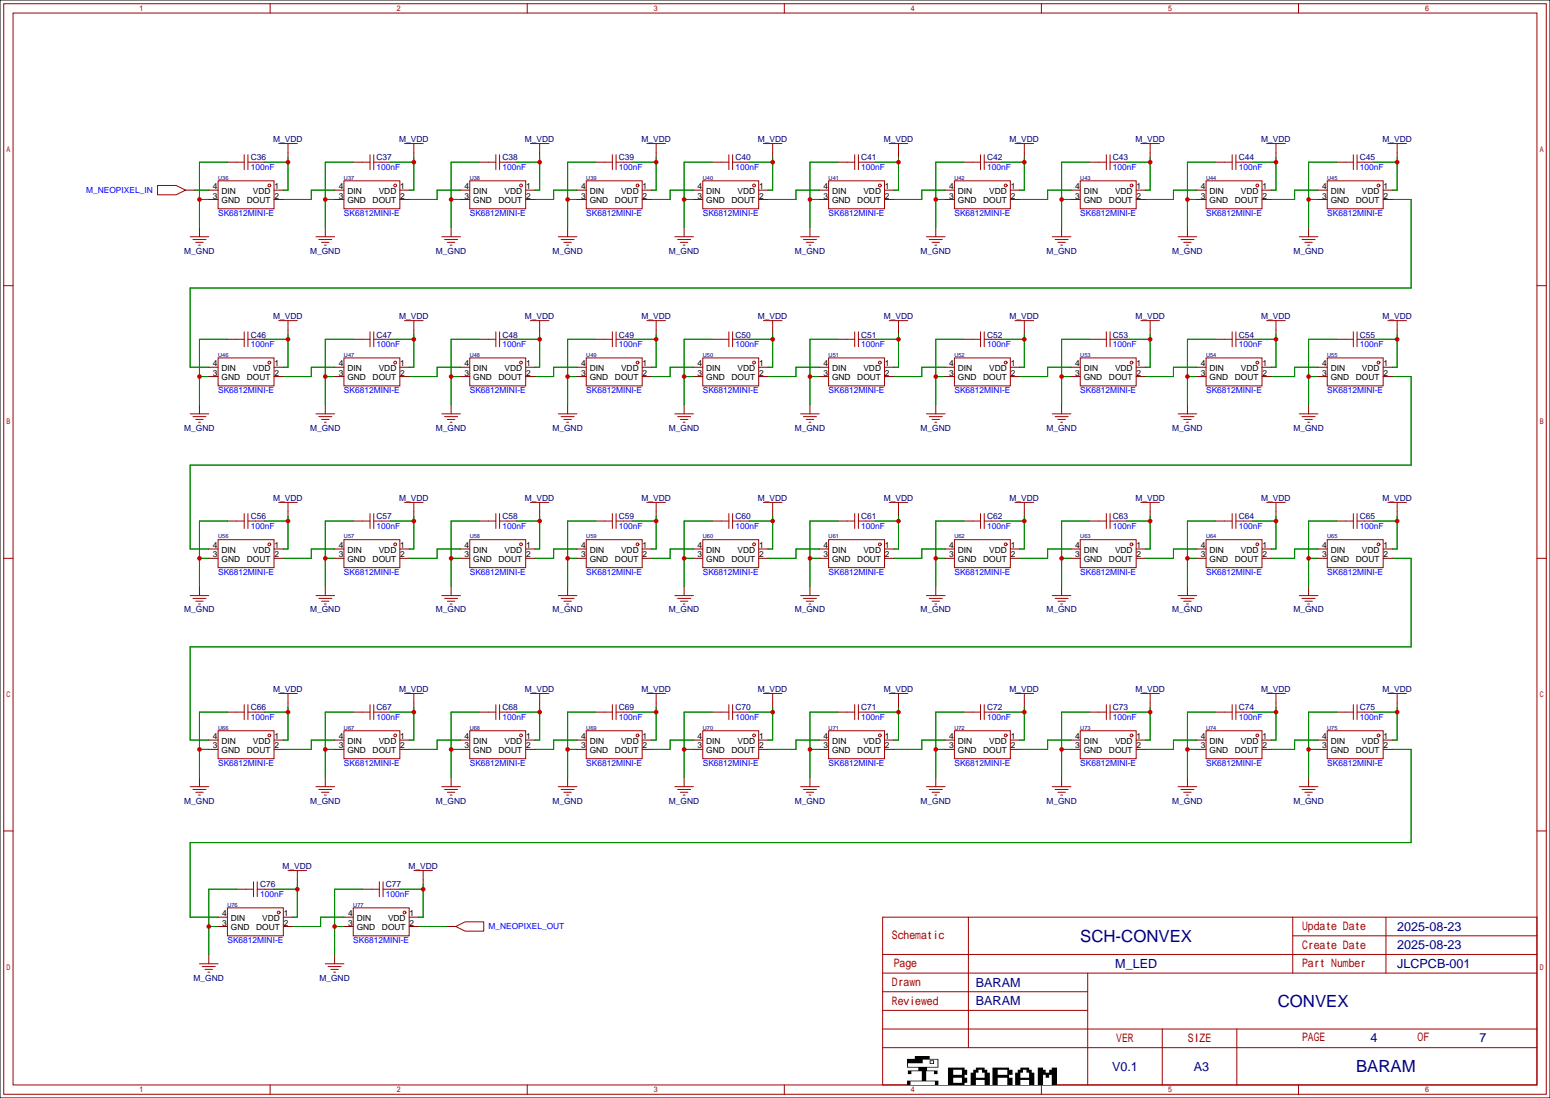
[picture p4: page 4]

PB12 51 VDD 50 VSS 49 VCAP 48 PB11 47 PB10 46 PE15 45 PE14 44 PE13 43 PE12 42 PE11 41 PE10 40 PE9 39 PE8 38 PE7 37 PB2 36 PB1 35 PB0 34 PC5 33 PC4 32 PA7 31 PA6 30 PA5 29 PA4 28 VDD 27 VSS 26 PA3 25 PA2 24 PA1 23 PA0 22 VDDA 21 VREF+ 20 VSSA 19 PC3_C 18 PC2_C 17 PC1 16 PC0 15 NRST 14 PH1-OSC_OUT 13 PH0-OSC_IN 12 VDD 11 VSS 10 PC15-OSC32_OUT 9

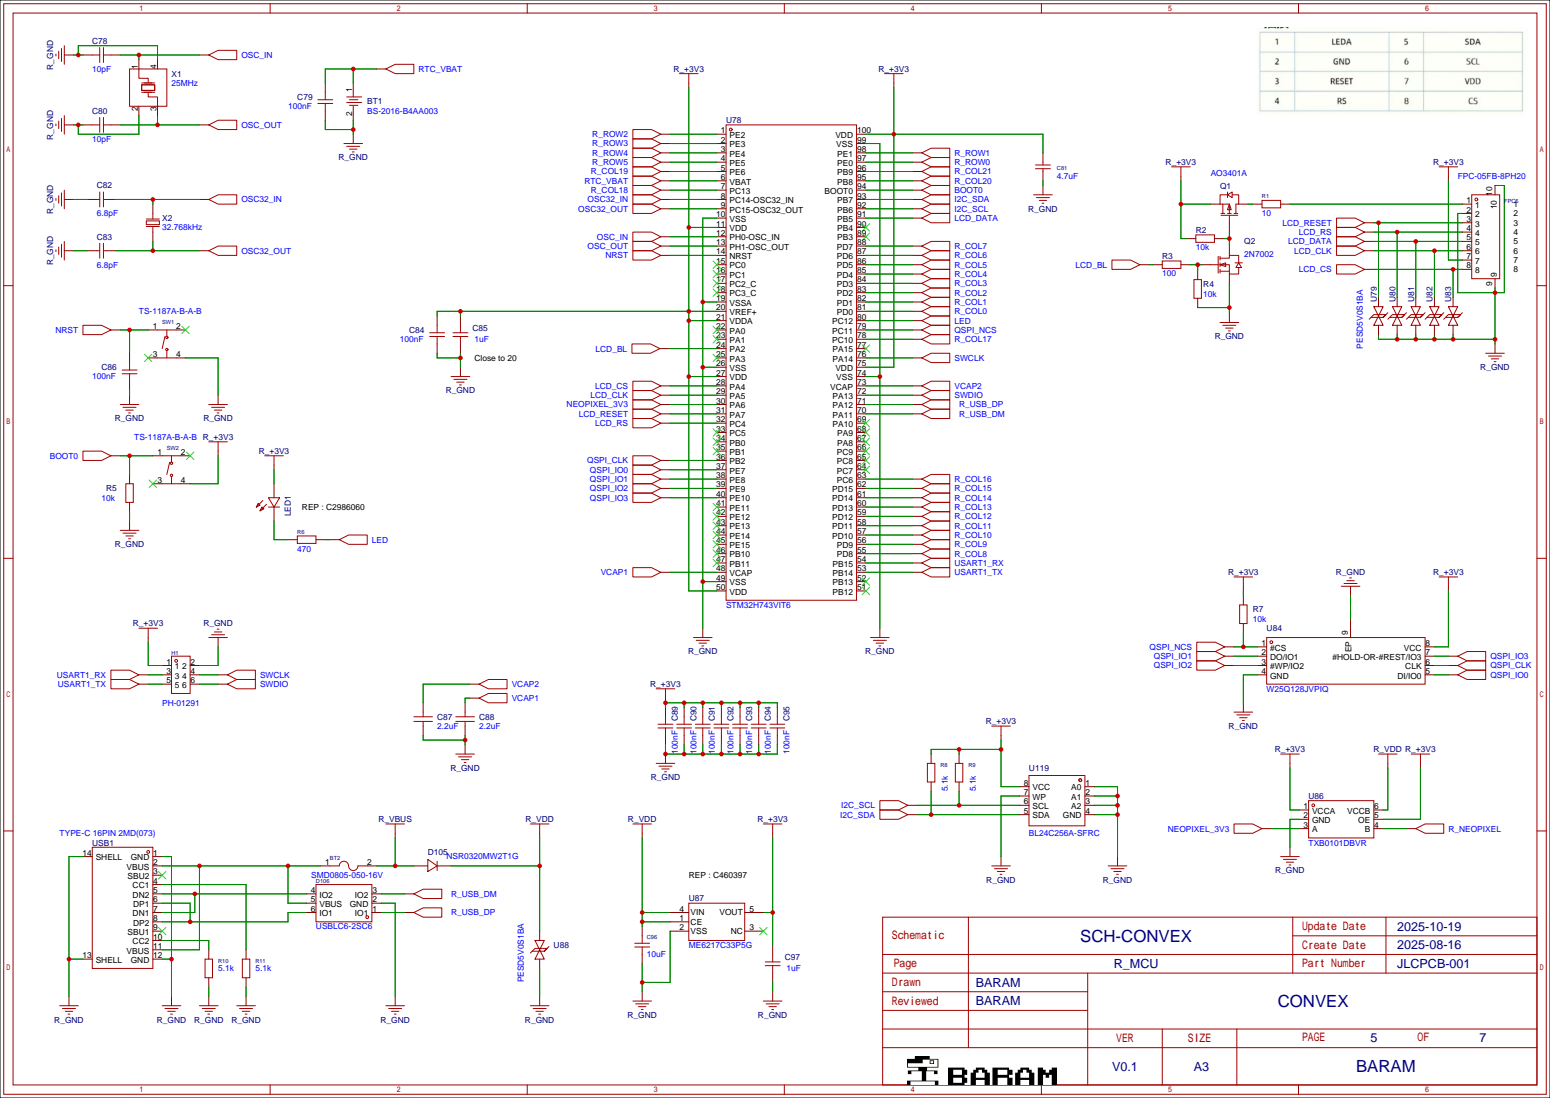
[picture p5: page 5]
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

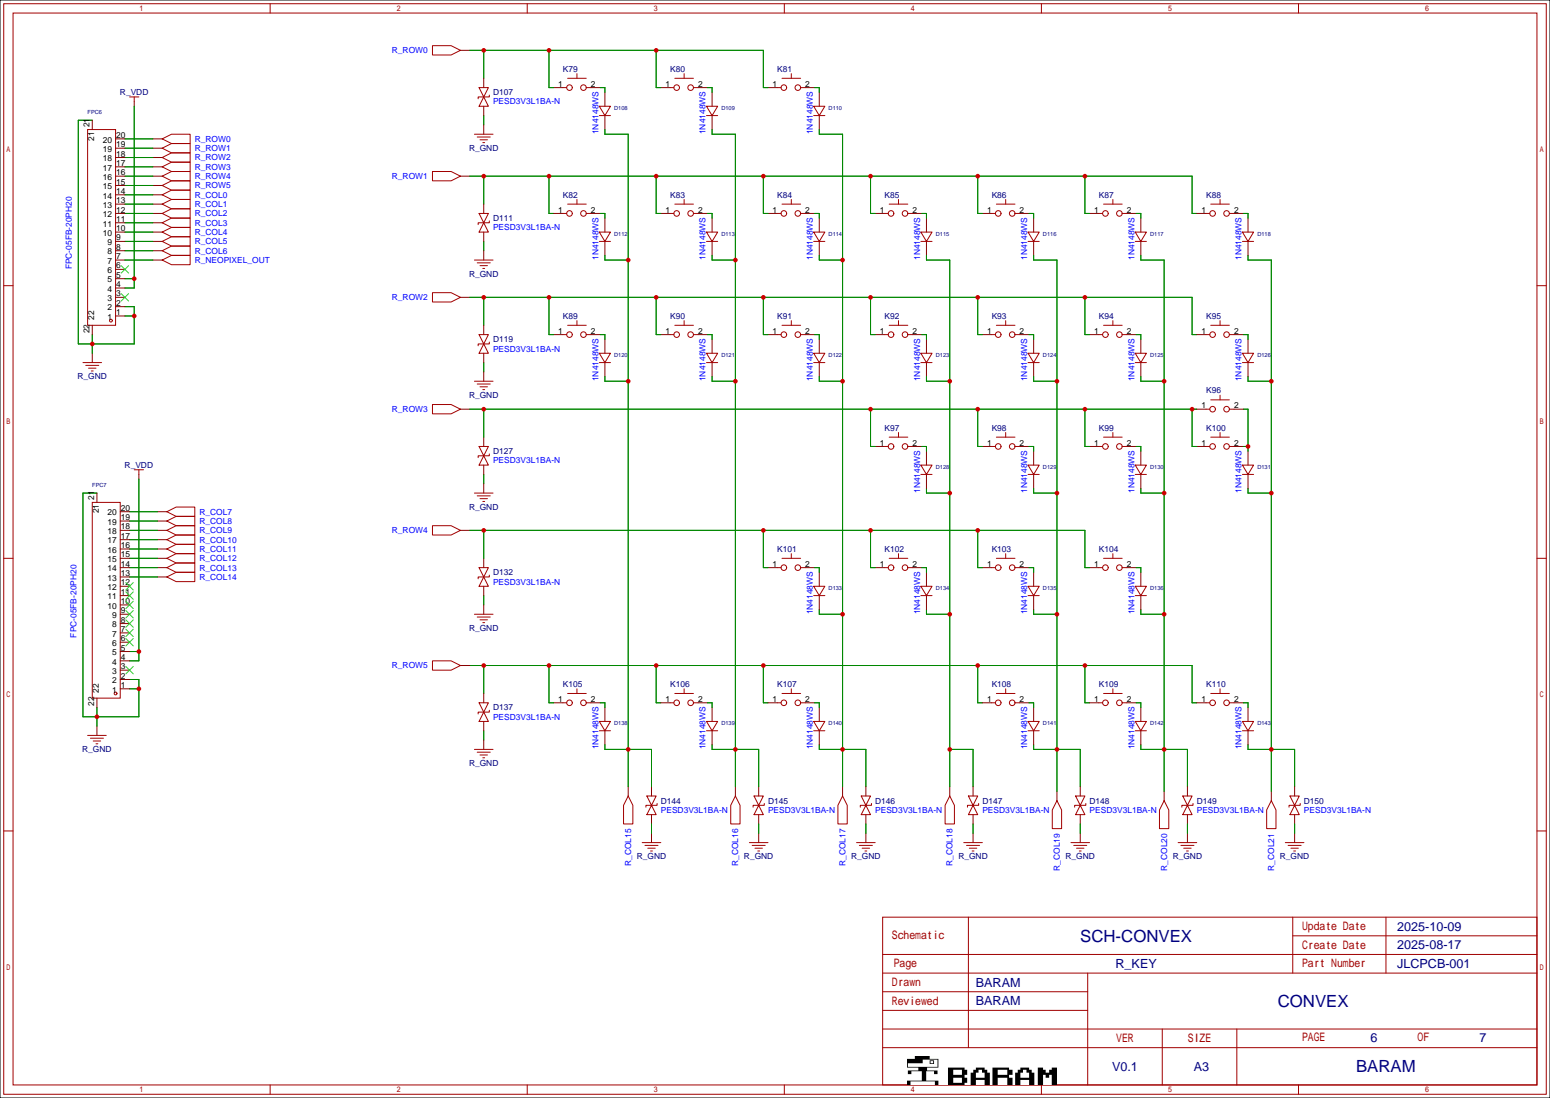
[picture p6: page 6]

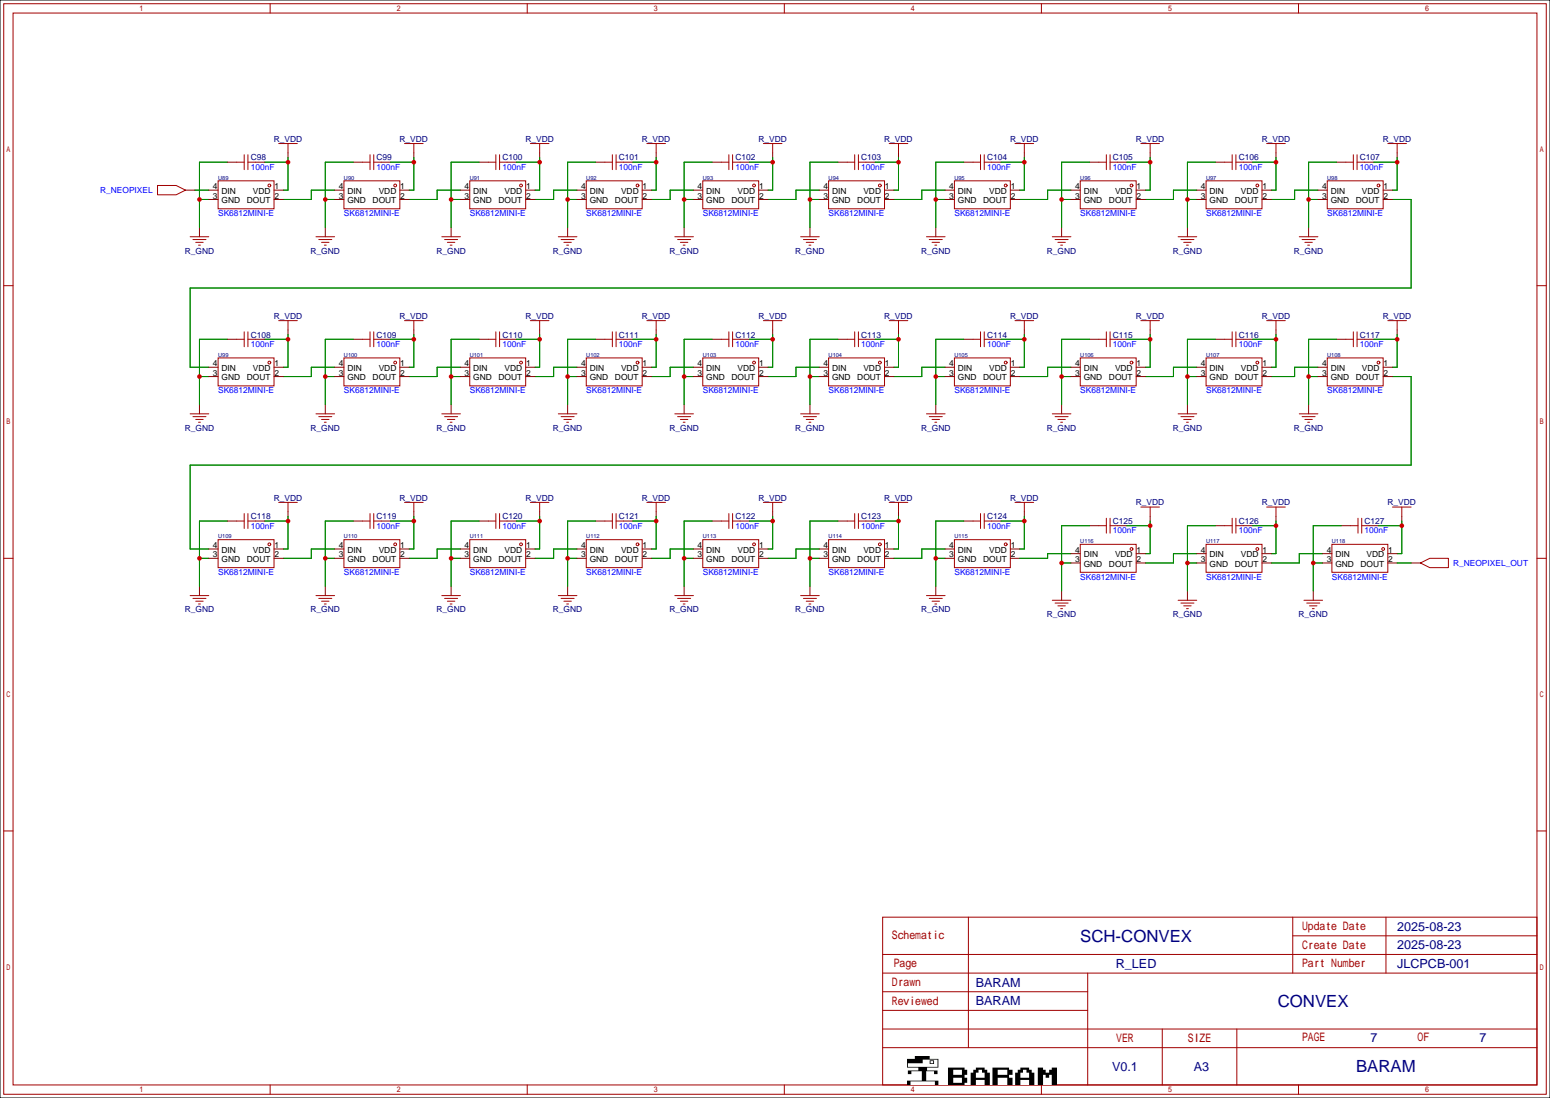
[picture p7: page 7]
