chcbaram/convex/hardware/SCH_SCH-LCD_2025-11-16.pdf

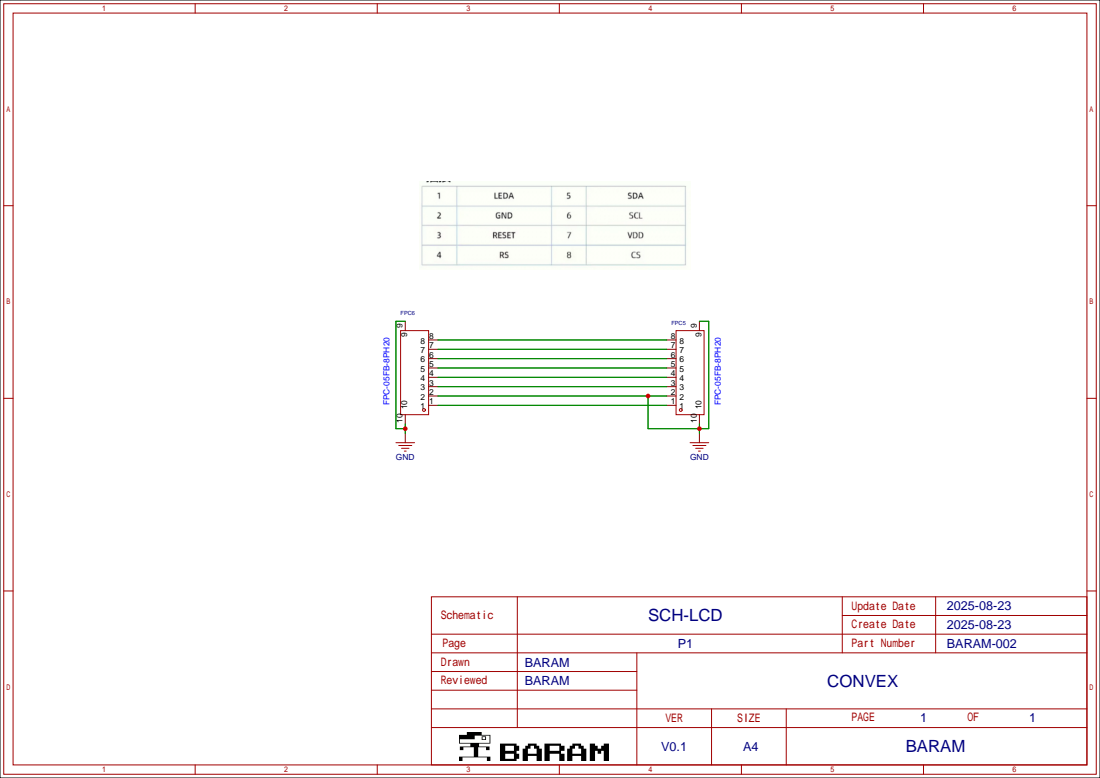
[picture p8: page 1]
