chcbaram/convex/firmware/convex-cube/convex.ioc

Mcu.UserName=STM32H743VITx
PA11.Signal=USB_OTG_FS_DM
PA12.Signal=USB_OTG_FS_DP
PA2.Signal=S_TIM15_CH1
PA5.Signal=SPI1_SCK
PA6.Signal=S_TIM3_CH1
PB14.Signal=USART1_TX
PB15.Signal=USART1_RX
PB2.Signal=QUADSPI_CLK
PB5.Signal=SPI1_MOSI
PB6.Signal=I2C1_SCL
PB7.Signal=I2C1_SDA
PC11.Signal=QUADSPI_BK2_NCS
PC12.GPIO_Label=LED
PC12.Signal=GPIO_Output
PD0.GPIO_Label=COL0
PD0.Signal=GPIO_Input
PD1.GPIO_Label=COL1
PD1.Signal=GPIO_Input
PD10.GPIO_Label=COL10
PD10.Signal=GPIO_Input
PD11.GPIO_Label=COL11
PD11.Signal=GPIO_Input
PD12.GPIO_Label=COL12
PD12.Signal=GPIO_Input
PD13.GPIO_Label=COL13
PD13.Signal=GPIO_Input
PD14.GPIO_Label=COL14
PD14.Signal=GPIO_Input
PD15.GPIO_Label=COL15
PD15.Signal=GPIO_Input
PD2.GPIO_Label=COL2
PD2.Signal=GPIO_Input
PD3.GPIO_Label=COL3
PD3.Signal=GPIO_Input
PD4.GPIO_Label=COL4
PD4.Signal=GPIO_Input
PD5.GPIO_Label=COL5
PD5.Signal=GPIO_Input
PD6.GPIO_Label=COL6
PD6.Signal=GPIO_Input
PD7.GPIO_Label=COL7
PD7.Signal=GPIO_Input
PD8.GPIO_Label=COL8
PD8.Signal=GPIO_Input
PD9.GPIO_Label=COL9
PD9.Signal=GPIO_Input
PE0.GPIO_Label=ROW0
PE0.Signal=GPIO_Output
PE1.GPIO_Label=ROW1
PE1.Signal=GPIO_Output
PE10.Signal=QUADSPI_BK2_IO3
PE2.GPIO_Label=ROW2
PE2.Signal=GPIO_Output
PE3.GPIO_Label=ROW3
PE3.Signal=GPIO_Output
PE4.GPIO_Label=ROW4
PE4.Signal=GPIO_Output
PE5.GPIO_Label=ROW5
PE5.Signal=GPIO_Output
PE7.Signal=QUADSPI_BK2_IO0
PE8.Signal=QUADSPI_BK2_IO1
PE9.Signal=QUADSPI_BK2_IO2
