chcbaram/convex/firmware/convex-cube/Core/Inc/main.h

#define ROW2_Pin GPIO_PIN_2
#define ROW2_GPIO_Port GPIOE
#define ROW3_Pin GPIO_PIN_3
#define ROW3_GPIO_Port GPIOE
#define ROW4_Pin GPIO_PIN_4
#define ROW4_GPIO_Port GPIOE
#define ROW5_Pin GPIO_PIN_5
#define ROW5_GPIO_Port GPIOE
#define COL8_Pin GPIO_PIN_8
#define COL8_GPIO_Port GPIOD
#define COL9_Pin GPIO_PIN_9
#define COL9_GPIO_Port GPIOD
#define COL10_Pin GPIO_PIN_10
#define COL10_GPIO_Port GPIOD
#define COL11_Pin GPIO_PIN_11
#define COL11_GPIO_Port GPIOD
#define COL12_Pin GPIO_PIN_12
#define COL12_GPIO_Port GPIOD
#define COL13_Pin GPIO_PIN_13
#define COL13_GPIO_Port GPIOD
#define COL14_Pin GPIO_PIN_14
#define COL14_GPIO_Port GPIOD
#define COL15_Pin GPIO_PIN_15
#define COL15_GPIO_Port GPIOD
#define LED_Pin GPIO_PIN_12
#define LED_GPIO_Port GPIOC
#define COL0_Pin GPIO_PIN_0
#define COL0_GPIO_Port GPIOD
#define COL1_Pin GPIO_PIN_1
#define COL1_GPIO_Port GPIOD
#define COL2_Pin GPIO_PIN_2
#define COL2_GPIO_Port GPIOD
#define COL3_Pin GPIO_PIN_3
#define COL3_GPIO_Port GPIOD
#define COL4_Pin GPIO_PIN_4
#define COL4_GPIO_Port GPIOD
#define COL5_Pin GPIO_PIN_5
#define COL5_GPIO_Port GPIOD
#define COL6_Pin GPIO_PIN_6
#define COL6_GPIO_Port GPIOD
#define COL7_Pin GPIO_PIN_7
#define COL7_GPIO_Port GPIOD
#define ROW0_Pin GPIO_PIN_0
#define ROW0_GPIO_Port GPIOE
#define ROW1_Pin GPIO_PIN_1
#define ROW1_GPIO_Port GPIOE
