chcbaram/convex/firmware/convex-qmk/src/hw/hw.h

#ifndef HW_H_
#define HW_H_

#ifdef __cplusplus
extern "C" {
#endif

#include "hw_def.h"

#include "osal/thread.h"

#include "led.h"
#include "uart.h"
#include "cli.h"
#include "log.h"
#include "usb.h"
#include "cdc.h"
#include "micros.h"
#include "button.h"
#include "gpio.h"
#include "keys.h"
#include "spi.h"
#include "qspi.h"
#include "eeprom.h"
#include "i2c.h"
#include "flash.h"
#include "rtc.h"
#include "reset.h"
#include "loader.h"
#include "ws2812.h"
#include "qbuffer.h"
#include "encoder.h"
#include "lcd.h"
#include "resize.h"
#include "swtimer.h"
#include "event.h"
#include "fs.h"
#include "nvs.h"
#include "pwm.h"
#include "lvgl.h"


bool hwInit(void);


#ifdef __cplusplus
}
#endif

#endif
