chcbaram/convex/firmware/convex-qmk/src/hw/driver/eeprom/bl24c256.c

#include "eeprom.h"


#if defined(_USE_HW_EEPROM) && defined(EEPROM_CHIP_BL24C256)
#include "i2c.h"
#include "cli.h"



#if CLI_USE(HW_EEPROM)
void cliEeprom(cli_args_t *args);
#endif


#define EEPROM_MAX_SIZE   (32*1024)


static bool is_init = false;
static uint8_t i2c_ch = _DEF_I2C1;
static uint8_t i2c_addr = 0x50;




bool eepromInit()
{
  bool ret;


  ret = i2cBegin(i2c_ch, 400);


  if (ret == true)
  {
    ret = eepromValid(0x00);
  }

  logPrintf("[%s] eepromInit()\n", ret ? "OK":"E_");
  if (ret == true)
  {
    logPrintf("     chip  : BL24C256\n");
    logPrintf("     found : 0x%02X\n", i2c_addr);
    logPrintf("     size  : %dKB\n", eepromGetLength()/1024);
  }
  else
  {
    logPrintf("     empty\n");
  }

#if CLI_USE(HW_EEPROM)
  cliAdd("eeprom", cliEeprom);
#endif

  is_init = ret;

  return ret;
}

bool eepromIsInit(void)
{
  return is_init;
}

bool eepromValid(uint32_t addr)
{
  uint8_t data;
  bool ret;

  if (addr >= EEPROM_MAX_SIZE)
  {
    return false;
  }

  ret = i2cReadA16Bytes(i2c_ch, i2c_addr, addr, &data, 1, 100);

  return ret;
}

bool eepromReadByte(uint32_t addr, uint8_t *p_data)
{
  bool ret;

  if (addr >= EEPROM_MAX_SIZE)
  {
    return false;
  }

  ret = i2cReadA16Bytes(i2c_ch, i2c_addr, addr, p_data, 1, 100);

  return ret;
}

bool eepromWriteByte(uint32_t addr, uint8_t data_in)
{
  uint32_t pre_time;
  bool ret;

  if (addr >= EEPROM_MAX_SIZE)
  {
    return false;
  }

  ret = i2cWriteA16Bytes(i2c_ch, i2c_addr, addr, &data_in, 1, 10);


  pre_time = millis();
  while(millis()-pre_time < 100)
  {

    ret = i2cIsDeviceReady(i2c_ch, i2c_addr);
    if (ret == true)
    {
      break;
    }
    delay(1);
  }

  return ret;
}

bool eepromRead(uint32_t addr, uint8_t *p_data, uint32_t length)
{
  bool ret = true;
  uint32_t i;


  for (i=0; i<length; i++)
  {
    ret = eepromReadByte(addr + i, &p_data[i]);
    if (ret != true)
    {
      break;
    }
  }

  return ret;
}

bool eepromWrite(uint32_t addr, uint8_t *p_data, uint32_t length)
{
  bool ret = false;
  uint32_t i;


  for (i=0; i<length; i++)
  {
    ret = eepromWriteByte(addr + i, p_data[i]);
    if (ret == false)
    {
      break;
    }
  }

  return ret;
}

uint32_t eepromGetLength(void)
{
  return EEPROM_MAX_SIZE;
}

bool eepromFormat(void)
{
  return true;
}




#if CLI_USE(HW_EEPROM)
void cliEeprom(cli_args_t *args)
{
  bool ret = true;
  uint32_t i;
  uint32_t addr;
  uint32_t length;
  uint8_t  data;
  uint32_t pre_time;
  bool eep_ret;


  if (args->argc == 1)
  {
    if(args->isStr(0, "info") == true)
    {
      cliPrintf("eeprom init   : %s\n", eepromIsInit() ? "True":"False");
      cliPrintf("eeprom length : %d bytes\n", eepromGetLength());
    }
    else if(args->isStr(0, "format") == true)
    {
      if (eepromFormat() == true)
      {
        cliPrintf("format OK\n");
      }
      else
      {
        cliPrintf("format Fail\n");
      }
    }
    else
    {
      ret = false;
    }
  }
  else if (args->argc == 3)
  {
    if(args->isStr(0, "read") == true)
    {
      addr   = (uint32_t)args->getData(1);
      length = (uint32_t)args->getData(2);

      if (length > eepromGetLength())
      {
        cliPrintf( "length error\n");
      }
      for (i=0; i<length; i++)
      {
        if (eepromReadByte(addr+i, &data) == true)
        {
          cliPrintf( "addr : %d\t 0x%02X\n", addr+i, data);          
        }
        else
        {
          cliPrintf("eepromReadByte() Error\n");
          break;
        }
      }
    }
    else if(args->isStr(0, "write") == true)
    {
      addr = (uint32_t)args->getData(1);
      data = (uint8_t )args->getData(2);

      pre_time = millis();
      eep_ret = eepromWriteByte(addr, data);

      cliPrintf( "addr : %d\t 0x%02X %dms\n", addr, data, millis()-pre_time);
      if (eep_ret)
      {
        cliPrintf("OK\n");
      }
      else
      {
        cliPrintf("FAIL\n");
      }
    }
    else
    {
      ret = false;
    }
  }
  else
  {
    ret = false;
  }


  if (ret == false)
  {
    cliPrintf( "eeprom info\n");
    cliPrintf( "eeprom format\n");
    cliPrintf( "eeprom read  [addr] [length]\n");
    cliPrintf( "eeprom write [addr] [data]\n");
  }

}
#endif 


#endif 
