chcbaram/convex/firmware/convex-boot/src/hw/hw.h

#ifndef HW_H_
#define HW_H_

#ifdef __cplusplus
extern "C" {
#endif

#include "hw_def.h"


#include "led.h"
#include "uart.h"
#include "cli.h"
#include "log.h"
#include "micros.h"
#include "button.h"
#include "keys.h"
#include "spi.h"
#include "eeprom.h"
#include "i2c.h"
#include "flash.h"
#include "rtc.h"
#include "reset.h"
#include "loader.h"
#include "util_core.h"
#include "qbuffer.h"
#include "qspi.h"
#include "gpio.h"
#include "lcd.h"
#include "resize.h"
#include "usb.h"
#include "ws2812.h"


bool hwInit(void);


#ifdef __cplusplus
}
#endif

#endif
