chcbaram/convex/(commit log)

2025-10-05 부트로더 프로젝트 추가
2025-10-05 i2c 추가
2025-10-05 eeprom 추가
2025-10-05 QSPI 메모리 추가
2025-10-05 LCD 작업중
2025-10-05 LCD 완료
2025-10-05 SPI 클럭 변경
2025-10-05 UF2 부트로더 추가
2025-10-09 KEYS 추가
2025-10-09 네오픽셀 추가
2025-10-09 키스캔 시간 확인 추가
2025-10-09 CubeMX 설정 변경
2025-11-08 초기 펌웨어 추가
2025-11-08 펌웨어 추가
2025-11-13 led 정리, assert 추가
2025-11-14 RGB 출력 개선
2025-11-14 RTOS 추가
2025-11-15 lfs, pwm 추가
2025-11-15 lvgl 런처 추가
2025-11-15 이벤트 처리 추가
2025-11-16 UI 버튼 연동 추가
2025-11-16 VIA로 시간 설정할 수 있게 추가
2025-11-16 부트로더 버전 변경
2025-11-16 회로도 추가
2025-11-16 VIA에서 날짜 수정 안되는 문제 수정
    [hw_def.h]
2026-04-12 계산기 추가중
2026-04-12 계산기 콤마 추가
2026-04-13 소수점 추가
2026-04-13 색상 변경 추가
2026-04-18 UF2 gif 추가
2026-04-18 부트로더 개선
2026-04-18 uf2 파일명 변경
2026-04-18 Revert "uf2 파일명 변경"
    This reverts commit 47aa7b7be53777502c81372f8dee8d7960cf1763.
2026-04-18 QMK Suspen/Resume 지원
2026-04-19 SLOT 지원
2026-04-19 LCD 백라이트 조정 변경
2026-04-19 앱 순서 변경
2026-04-19 SLOT 지우기 추가
2026-06-04 마우스키 기능 추가
2026-08-14 UF2 기록을 블록 순서/중복에 무관하게 변경
    호스트가 블록을 임의 순서로 보내거나 재전송하면 플래시 내용과 태그의
    CRC/크기가 틀어졌다. erase 를 64KB 섹터 비트맵으로 전송당 1회만 하고,
    중복 블록은 writtenMask 로 걸러내며, CRC 는 flush 시 플래시를 다시
    읽어서 계산한다.
    Windows/macOS/Linux 에서 파일 복사가 실패하던 MSC 동작도 함께 고쳤다.
    SYNCHRONIZE CACHE 에 STALL 대신 정상 응답하고, eject 와 펌웨어 갱신을
    USB 콜백 밖으로 옮겼으며, 기록 실패를 호스트에 오류로 알린다.
    [usb.c, usb.h]
2026-08-14 앱 경유 웹 업데이트 계획과 부트로더 자체 갱신 검토 문서 추가
2026-08-14 플래시 사용 현황 실측과 A/B 부트로더 갱신 방안 문서화
2026-08-14 압축 실측 결과와 드라이브 직접 복사 방안을 문서에 추가
2026-08-14 앱에 WebHID 펌웨어/슬롯 업데이트 경로 추가
    VIA raw HID(리포트 ID 0xC0)로 이미지를 받아 QSPI 에 기록하고 부트로더
    업데이트 모드로 리셋한다. DATA 패킷이 절대 오프셋을 실어 보내므로 순서와
    중복에 영향받지 않는다.
    리포트는 USB 인터럽트에서 큐에 넣고 스레드에서 처리한다. GIF 재생이 다른
    스레드에서 QSPI 를 읽으므로 QSPI 접근에 뮤텍스를 넣었다.
2026-08-14 슬롯 삭제를 기록된 크기만큼만 지우도록 변경
    슬롯 전체(2MB)를 지우면 64KB 섹터 32개라 5초 가까이 걸려 키 입력 처리가
    그동안 멈춘다. 헤더의 파일 크기를 읽어 기록된 범위만 지운다. 헤더만
    지우면 뒤쪽 데이터가 남아 이후 새 GIF 를 쓸 때 지워지지 않은 영역에
    덮어쓰게 되므로 범위 전체를 지운다.
2026-08-14 웹페이지에 WebHID 업데이트와 펌웨어 릴리스 추가
    GIF 슬롯과 펌웨어를 탭으로 나누고, 연결된 기기에 WebHID 로 바로 전송할
    수 있게 했다. INFO 응답이 없으면 웹 업데이트를 지원하지 않는 펌웨어로
    보고 안내를 띄운다.
    펌웨어 바이너리를 firmware/release 에 넣고 manifest.json 으로 목록을
    관리해 여러 버전 중에서 고를 수 있게 했다. 부트로더 드라이브에 UF2 를
    바로 쓰는 경로와 기존 다운로드 방식도 함께 남겼다.
    GIF 는 파일의 해상도를 읽어 LCD(284 x 76) 와 비교해 보여준다.
    앱과 부트로더 버전을 V260814R1 로 올렸다.
2026-08-14 슬롯 목록 방식 검토 내용 문서에 추가
2026-08-14 슬롯 목록 검토를 파일 1개 + 라디오 선택 방식으로 정리
2026-08-14 GIF 미리보기 방안을 검토 문서에 추가
2026-08-14 슬롯 목록과 GIF 미리보기 추가
    슬롯을 드롭다운 대신 목록으로 보여주고 라디오로 하나를 고른다.
    장치에 CMD_SLOT 을 추가해 슬롯별 사용 여부, 크기, 종류, GIF 해상도를
    읽어 표시하고, 내용이 있는 슬롯을 고르면 덮어쓴다고 알린다.
    전송이 끝나면 해당 슬롯 상태를 다시 읽는다.
    파일을 고르면 LCD 와 같은 284x76 검정 배경 틀에 미리보기를 띄워
    잘리는 부분을 그대로 보여준다. 다만 브라우저와 LVGL 의 디코더가 달라
    재생 가능 여부까지 보장하지는 않는다.
    예제 GIF 두 개를 tools/make_sample_gif.py 로 생성해 넣었다. 외부
    라이브러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
2026-08-14 예제 GIF 링크를 버튼으로 바꾸고 동작을 문구로 명시
2026-08-14 슬롯에 이름을 저장하고 목록에 표시
    슬롯 데이터 헤더의 빈 자리를 써서 이름 16바이트와 종류를 함께 저장한다.
    슬롯 목록에 "이름 - 이미지 284x76 412KB" 형태로 보여준다.
    이전 데이터 호환:
    - gif_app.c 가 읽는 +16(크기), +32(GIF 시작) 위치는 그대로 둔다.
    구버전 펌웨어가 새 데이터를 읽어도 문제없다.
    - [20..23] 에 "SLT1" 매직을 두고, 없으면 구버전으로 보아 이름은 비우고
    종류만 옛 문자열("GIF_MOVIE")에서 되살린다.
    이름은 UTF-8 로 자르되 글자 중간에서 끊기지 않게 하고, 입력란에 사용
    바이트 수를 표시한다. 파일을 고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
2026-08-14 설정 탭에 RTC 시간 동기화와 펌웨어 릴리즈 노트 추가
    장치에 CMD_RTC 를 추가해 웹페이지에서 시간을 읽고 쓴다. PC 시간으로
    한 번에 맞추거나 직접 입력할 수 있고, 기기 시간이 PC 와 얼마나 차이
    나는지 함께 보여준다. 요일은 장치가 날짜에서 계산하므로 보내지 않는다.
    펌웨어 탭에서는 manifest 의 notes 를 목록으로 보여준다.
    make_release.py 에 --note 를 넣었고, 주지 않으면 기존 노트를 유지한다.
2026-08-14 펌웨어 탭에 현재 기기 버전과 선택 버전의 관계 표시
2026-08-14 README 에 프로젝트 소개와 웹페이지 주소 추가
2026-08-14 웹 업데이트 수정과 슬롯 기능 추가
    - 슬롯 상태/RTC 명령이 디스패치에 없어 응답하지 않던 문제 수정
    - 응답 없는 리포트(DATA) 뒤 USB OUT 엔드포인트를 재장전하지 않아
    대량 전송이 두 번째 리포트에서 끊기던 문제 수정
    - 부트로더에서 넘어올 때 버스에서 분리하지 않아 호스트가 다시
    열거하지 않던 문제를, 앱 USB 초기화 전 풀업을 떼어 해결
    - SHOW/READ 명령 추가 (프로토콜 v2). 슬롯 선택 시 기기 화면 전환,
    저장된 GIF 내려받기
    - 웹페이지 : 부트로더로 재시작, 슬롯별 다운로드 버튼, 파일 종류
    자동 판별(프레임 수), 이름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
    [fwupdate.c, fwupdate.h, hw_def.h]
2026-08-14 업데이트 진행 화면과 슬롯 삭제 추가
    - 업데이트/삭제 중 LCD 에 대상과 진행률을 표시하는 화면 추가.
    앱 전환 순서와 EEPROM 저장에서는 빠지고, 끝나면 원래 앱으로 돌아간다.
    GIF 재생이 멈춰 QSPI 를 두고 다투지 않는 효과도 있다
    - 진행 중에는 화면·슬롯을 건드리는 키만 무시한다. 타자는 그대로 둔다
    - ERASE 명령 추가. 기록된 크기만큼만 지우고 섹터마다 진행률을 남긴다
    - 전송이 끊긴 슬롯을 태그로 걸러낸다. 크기 필드는 첫 리포트에 들어 있어
    끊겨도 남기 때문에, 태그의 매직과 CRC 를 확인해야 알 수 있다
    - 웹페이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
2026-08-14 스펙트럼 앱과 릴리즈 묶음 다운로드 추가
    - 키 입력에 반응하는 스펙트럼 애널라이저 앱. 막대 위치는 매트릭스 col,
    높이는 row 로 정한다. 아래 열일수록 높게 튄다. 키 위치만 넘기고
    true 를 반환하므로 타자는 그대로 쳐진다
    - 진입은 앱 전환 순환과 VIA 커스텀 키코드(UI_SPT) 둘 다
    - 릴리즈에 VIA 정의를 같은 버전으로 포함. 커스텀 키코드가 펌웨어와
    함께 바뀌므로 따로 두면 어긋난다
    - 펌웨어 탭에서 UF2 와 JSON 을 zip 하나로 받는다. 저장소에 zip 을 두면
    같은 내용이 두 벌이 되므로 페이지에서 묶는다
    - 릴리즈 파일을 버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
2026-08-14 스펙트럼 앱 감쇠와 색 다듬기, 표시 전송 수정
    - disp_flush() 가 바뀐 영역마다 화면 전체를 보내고 있었다. DIRECT 모드는
    프레임당 한 번이면 된다. 객체가 많은 화면이 GIF 보다 느렸던 이유다
    - 막대는 지수 감쇠. 선형으로 깎으면 낙하가 몇 단계뿐이라 계단으로 보이고,
    단계를 잘게 하면 이번엔 느려진다
    - 피크는 예제 GIF 과 같은 속도로 선형 하강(초당 60%). 지수로 하면 끝에서
    한없이 느려져 꼭대기에 남는다. 150ms 유지 후 내려온다
    - 피크가 막대 끝에 붙어 있을 때는 숨긴다. 겹쳐서 깜빡이는 것처럼 보인다
    - 색은 문턱값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
2026-08-18 웹 GIF 선택 오류 수정과 로고 예제 추가
    Blob 에 bytes() 메서드가 생기면서 File 을 예제 파일({name, bytes})로
    잘못 판별해, 크기가 0 으로 보이고 전송·UF2 에 GIF 데이터가 빠졌다.
    고른 파일도 { name, bytes } 로 통일한다.
    284x76 CONVEX 로고 애니메이션 예제와 생성 스크립트를 추가한다.
2026-08-18 GIF 화면 맞추기와 끌어 놓기 추가
    LCD 와 크기가 다른 GIF 는 넣을 때 284 x 76 으로 바꿔서 저장한다.
    펌웨어는 GIF 캔버스 전체를 ARGB8888 로 잡아 두어(lv_gif.c) 폭 480 을
    넘거나 LVGL 힙 256KB 를 넘는 GIF 는 기기에서 열지 못했다.
    - 맞추기 4가지 : 원본 / 폭 맞추기 / 높이 맞추기 / 늘리기.
    파일을 고르면 잘리지 않는 쪽이 자동으로 선택된다.
    - 넘치는 축은 끌어서 위치를 조절한다. 방향키와 가운데 버튼도 된다.
    - 미리보기와 변환이 같은 값(ox, oy, dw, dh)을 쓰므로 보이는 대로 저장된다.
    - 변환은 ImageDecoder 로 프레임을 꺼내 캔버스에 다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
