chcbaram/convex/(notices)

Notices in the files:
firmware/convex-cube/Core/Inc/main.h:
Copyright (c) 2025 STMicroelectronics.
All rights reserved.
This software is licensed under terms that can be found in the LICENSE file
firmware/convex-qmk/src/ap/modules/qmk/quantum/via.h:
This program is free software: you can redistribute it and/or modify
it under the terms of the GNU General Public License as published by
the Free Software Foundation, either version 2 of the License, or
(at your option) any later version.
